cpresser/karatelight/KarateLight_v06b/switcher.jpg

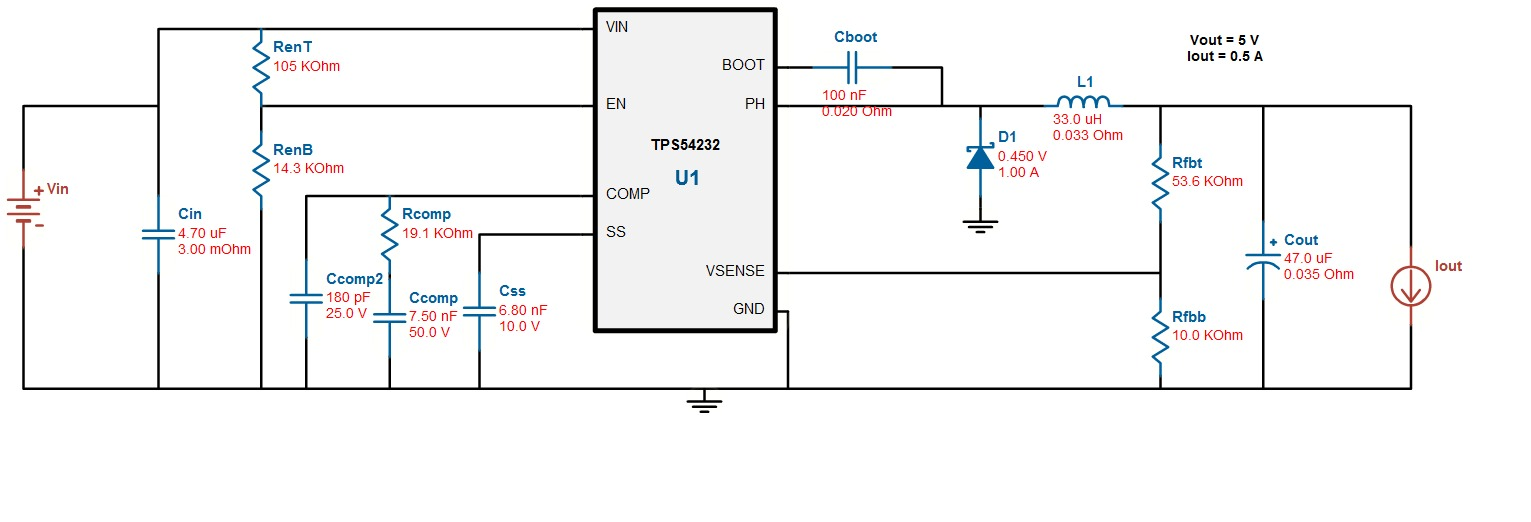
KarateLight_v06b/switcher.jpg
