cpresser/karatelight/KarateLight_v06b/bom/BOM.ods

Sheet: KarateLight BOM
Qty | THT | Reel | Value | Device | Package | Parts | Description | Lager | Reichelt | Preis10 | Digikey | Price 10
8 | Yes |  | PINHEAD_4W | PINHEAD_4W | MA04-1 | CON1, CON2, CON3, CON4, CON5, CON6, CON7, CON8 |  |  | PSS 254/4W | 4,03 €
3 | Yes |  |  | PINHD-2X4 | 2X04 | PIGGY_PWR, PIGGY_SIG, PIGGY_SUPPORT | PIN HEADER |  | MPE 094-2-008 | 6,55 € | S7072-ND | 19,65 €
2 |  | Yes | 100n | C-EUC0603 | C0603 | C3, C5 | CAPACITOR, European symbol | R
2 |  | Yes | 10k | R-EU_R0603 | R0603 | R25, R28 | RESISTOR, European symbol | R
6 |  | Yes | CTS742C083R | CTS742C083R | CTS742C083 | RN1, RN2, Rn3, RN4, RN5, RN6 | Chip Resistor Array 4 Single Resistor | R | BCN16 10K | 1,01 €
2 |  |  | 100u 24V | CPOL-EU153CLV-0605 | 153CLV-0605 | C1, C2 | POLARIZED CAPACITOR, European symbol |  | VF 100/35 K-D8 | 3,03 €
12 |  |  | IRF7103 | IRF7103 | SO08-IRF | T1, T2, T3, T4, T5, T6, T7, T8, T9, T10, T11, T12 | Dual HexFET Power Mosfet |  | IRF 7103 | 32,26 € | IRF7103PBF-ND | 43,18 €
1 |  |  | IRF7389 | IRF7389 | SO08-IRF | T13 | Complimentary Half Bridge HEXFET Power MOSFET |  | IRF 7389 | 4,79 € | IRF7389PBFCT-ND | 8,21 €
1 |  |  | TLC5947 | TLC5947 | TSSOP32 | IC1 | 24CH PWM LED Driver |  |  |  | 296-23576-5-ND | 49,88 €
1 | Yes |  | PG203J | PG203J | PG203J | PLUG_LDR | MIC/HEADPHONE JACK |  | EBS 35 | 2,67 €
1 | Yes |  |  | DCJ0303 | DCJ0303 | VIN | DC POWER JACK |  | HEBW 21 | 2,10 €
8 | Yes |  | PINHEAD_4W | PINHEAD_4W | MA04-1 | CON1, CON2, CON3, CON4, CON5, CON6, CON7, CON8 |  |  | PSS 254/4W | 4,03 €
3 | Yes |  |  | PINHD-2X4 | 2X04 | PIGGY_PWR, PIGGY_SIG, PIGGY_SUPPORT | PIN HEADER |  | MPE 087-2-008 | 5,04 € | PH2-230/120-081-ND | 4,59 €
6 |  | Yes | 10k | R-EU_R0603 | R0603 | R25, R26, R28, R31, R32, R33 | RESISTOR, European symbol | R
2 |  | Yes | 10n | C-EUC0603 | C0603 | C7, C11 | CAPACITOR, European symbol
2 |  | Yes | 15p | C-EUC0603 | C0603 | C15, C16 | CAPACITOR, European symbol
1 |  | Yes | 180p | C-EUC0603 | C0603 | C9 | CAPACITOR, European symbol
1 |  | Yes | 19.1k | R-EU_R0603 | R0603 | R27 | RESISTOR, European symbol | 150 20k5
6 |  | Yes | 100n | C-EUC0603 | C0603 | C6, C10, C12, C5, C13, C14 | CAPACITOR, European symbol | R
1 |  |  | 1u | C-EUC0805 | C0805 | C18 | CAPACITOR, European symbol |  | X7R-G0805 1,0/16 | 0,40 €
1 |  | Yes | 43k | R-EU_R0603 | R0603 | R30 | RESISTOR, European symbol
1 |  | Yes | 7n5 | C-EUC0603 | C0603 | C8 | CAPACITOR, European symbol
1 |  | Yes | 8k2 | R-EU_R0603 | R0603 | R29 | RESISTOR, European symbol
6 |  | Yes | CTS742C083R | CTS742C083R | CTS742C083 | RN1, RN2, Rn3, RN4, RN5, RN6 | Chip Resistor Array 4 Single Resistor |  | BCN16 10K | 1,01 €
1 |  | DR | green | LEDCHIP-LED0805 | CHIP-LED0805 | LED2 | LED |  | SMD-LED 0805 GN | 0,67 €
1 |  | DR | red | LEDCHIP-LED0805 | CHIP-LED0805 | LED1 | LED |  | SMD-LED 0805 RT | 0,67 €
1 |  |  | 20MHz | CRYSTALHC49UP | HC49UP | Q1 | CRYSTAL |  | 20,0000-HC49-SMD | 1,60 €
1 |  |  | 33u | L-EUPIS2816 | PIS2816 | L1 | INDUCTOR, European symbol |  | L-PIS2816 33µ | 5,21 €
2 |  |  | 4.7u | CPOL-EU153CLV-0405 | 153CLV-0405 | C3, C4 | POLARIZED CAPACITOR, European symbol |  | SMD ELKO 4,7/35 | 0,67 €
1 |  |  | USB-B-S | USB-B-S | USB-B-SMT | PLUG_USB | USB Connectors |  | USB BW SMD | 3,36 €
1 |  |  |  | R-EU_R4527 | R4527 | FUSE | RESISTOR, European symbol |  |  |  | F1228CT-ND | 19,28 €
2 |  |  | 100u 24V | CPOL-EU153CLV-0605 | 153CLV-0605 | C1, C2 | POLARIZED CAPACITOR, European symbol |  | VF 100/35 K-D8 | 3,03 €
1 |  |  |  | TASTER-9314_SMD | TASTER-9314_SMD | BOOT |  |  | Taster 9315 | 1,68 €
1 |  |  |  | SCHOTTKY-DIODESMD | SMB | D1 | Schottky Diode |  | MBRS 240 SMD | 1,85 €
12 |  |  | IRF7103 | IRF7103 | SO08-IRF | T1, T2, T3, T4, T5, T6, T7, T8, T9, T10, T11, T12 | Dual HexFET Power Mosfet |  | IRF 7103 | 32,26 €
1 |  |  | IRF7389 | IRF7389 | SO08-IRF | T13 | Complimentary Half Bridge HEXFET Power MOSFET |  | IRF 7389 | 4,79 €
1 |  |  | PIC18F4550_TQFP | PIC18F4550_TQFP | TQFP44 | IC2 | USB Microcontrollers with nanoWatt Technology High-Performance, Enhanced Flash, 28/40/44-Pin, |  | PIC 18F4550-I/PT | 48,73 €
1 |  |  | TLC5947 | TLC5947 | TSSOP32 | IC1 | 24CH PWM LED Driver |  |  |  | 296-23576-5-ND | 49,88 €
1 |  |  | TPS54232 | TPS54232 | SO-08 | IC3 | TPS54232 2-A, 28-V, 1-MHz, Step-Down DC-DC Converter With Eco-Mode |  |  |  | 296-24037-5-ND | 17,40 €
 |  |  |  |  |  |  |  |  |  | 171,44 € |  | 117,16 € | 28,86 €

Sheet: Staffelpreise
 |  |  | 10 | 25 | 100
TPS54232 | @Digikey | 296-24037-5-ND | 1,74 € | 1,41 € | 1,27 €
 | @Mouser | 595-TPS54232DR | 1,43 € | 1,29 € | 1,12 €
PIC18F4550 | @Digikey | PIC18F4550T-I/PTCT-ND | 5,04 € | 4,09 € | 4,00 €
 | @Reichelt | PIC 18F4550-I/PT | 4,87 € | 4,87 € | 4,87 €
 | @Mouser | 579-PIC18F4550-I/PT | 4,76 € | 3,87 € | 3,82 €
PIC18F45K50 | @Digikey | PIC18F45K50-I/PT-ND | 3,12 € | 2,38 € | 2,15 €
 | @Mouser | 579-PIC18F45K50-I/PT | 2,98 € | 2,27 € | 2,05 €
TLC5947DAP | @Mouser | 595-TLC5947DAP | 4,76 € | 4,28 € | 3,90 €
 | @Digikey | 296-23576-5-ND | 4,98 € | 4,98 € | 4,09 €
IRF7103 | Bei Digikey ab 4000 Günstiger

Sheet: Reel
Name | Digikey | Menge | Preis
Resistor Network 10k 1206 | YC164J-10KTR-ND | 5000 | 20,26
Cap 15p | 1276-1296-1-ND | 500 | 4,02
Cap 180p | 1276-1255-1-ND | 500 | 4,24
Cap 10n | 1276-1921-2-ND | 4000 | 13,34
Res 8k2 | RHM8.2KCFTR-ND | 5000 | 6,48
Cap 6,8n | 1276-2103-1-ND | 100 | 1,56
Res 43k | RHM43KCFTR-ND | 5000 | 6,48
Res 1k | 311-1.0KGRTR-ND | 5000 | 5,65

Sheet: Sicherungen
 |  | Price 10
5A, SMD, kein Halter | MFU06035.00CT-ND | 2,05
Schurter Inc. 0031.7701.11 | 486-1991-ND | 11,1 | Holder
 | OMT 125 5,0A | 5 | Fuse
Littelfuse Inc. 0154005.DR | F1228CT-ND | 19.28 | Fuse + Holder
