cpresser/karatelight/KarateLight_v06b/stencil/KarateLight-exp.dxf

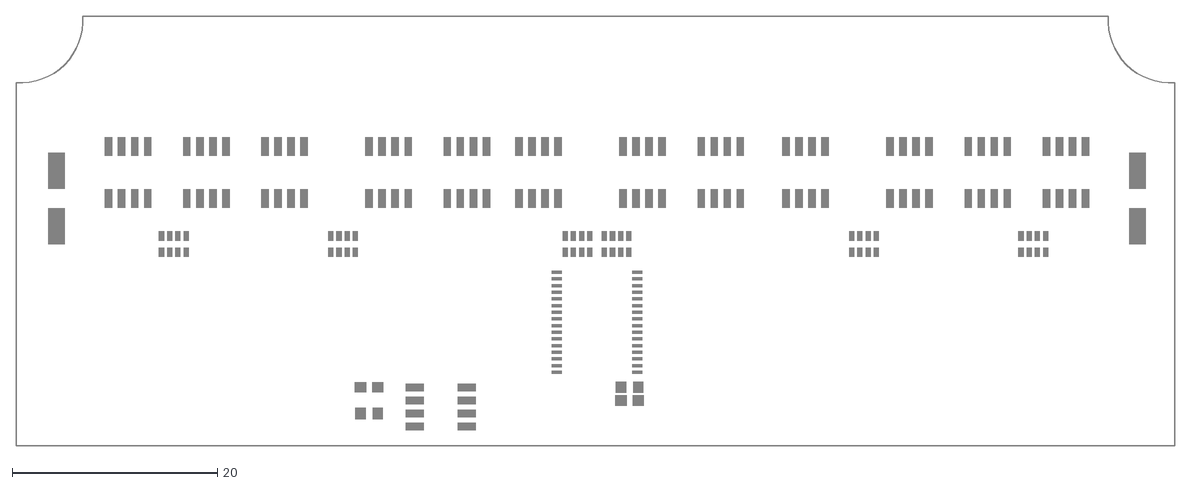
[picture p2: CAD file, 2017-12-09]
KarateLight_v06b/stencil/KarateLight-exp.dxf
113.0 x 41.9
