cpresser/karatelight/KarateLight_v06b/stencil/KarateLight.dxf

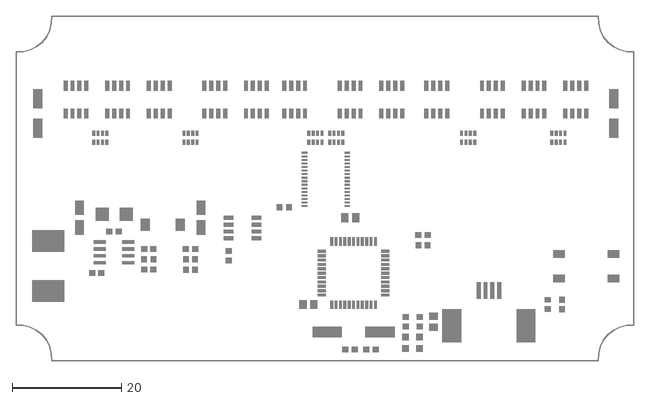
[picture p3: CAD file, 2017-12-09]
KarateLight_v06b/stencil/KarateLight.dxf
113.0 x 63.0
