cpresser/karatelight/(list of files, cad)

Other CAD files:
Firmware/karate_xc8.X/dist/18F4550/production/karate_xc8.X.production.obj
Firmware/karate_xc8.X/dist/18F45k50-relocation/production/karate_xc8.X.production.obj
Firmware/karate_xc8.X/dist/18F45k50/production/karate_xc8.X.production.obj
Firmware/karate_xc8.X/dist/default/production/karate_xc8.X.production.obj
