cpresser/karatelight/KarateLight_v06b/KarateLight.brd

## EAGLE design KarateLight_v06b/KarateLight.brd (2017-12-09)

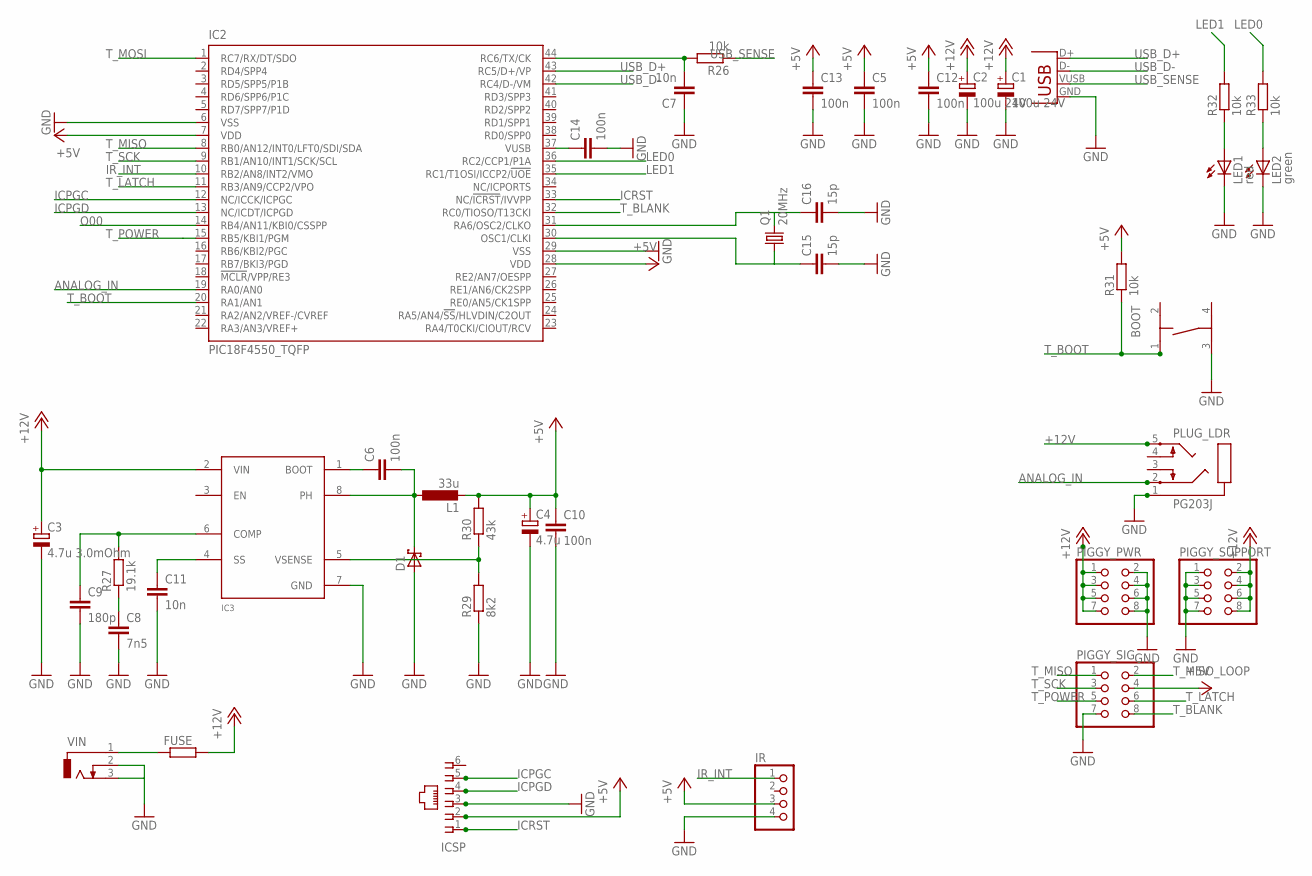
[picture p4: schematic KarateLight.sch, sheet 1]

Parts:
BOOT: TASTER-9314_SMD
C1, C2: 100u 24V; 153CLV-0605
C3: 4.7u 3.0mOhm; 153CLV-0405
C4: 4.7u; 153CLV-0405
C5, C13, C14: 100n; C0805K
C6, C10, C12: 100n; C0603
C7, C11: 10n; C0603
C8: 7n5; C0603
C9: 180p; C0603
C15, C16: 15p; C0603
D1: SCHOTTKY-DIODESMD; SMB
FUSE: R-EU_R4527; R4527
IC2: PIC18F4550_TQFP; TQFP44
IC3: TPS54232; SO-08
ICSP: 520250-3
IR: PINHD-1X4; 1X04
L1: 33u; PIS2816
LED1: red; CHIP-LED0805
LED2: green; CHIP-LED0805
PIGGY_PWR: PINHD-2X4; 2X04
PIGGY_SIG: PINHD-2X4; 2X04
PIGGY_SUPPORT: PINHD-2X4; 2X04
PLUG_LDR: PG203J
PLUG_USB: USB-B-S; USB-B-SMT
Q1: 20MHz; HC49UP
R26, R31, R32, R33: 10k; R0603
R27: 19.1k; R0603
R29: 8k2; R0603
R30: 43k; R0603
VIN: DCJ0303

Connections:
+5V: C4.+, C5.1, C10.1, C12.1, C13.1, IC2.7 (VDD), IC2.28 (VDD), ICSP.2, IR.3, L1.2, PIGGY_SIG.4, R30.2, R31.2; also elsewhere on the board
+12V: C1.+, C2.+, C3.+, FUSE.2, IC3.2 (VIN), PIGGY_PWR.1, PIGGY_PWR.3, PIGGY_PWR.5, PIGGY_PWR.7, PIGGY_SUPPORT.2, PIGGY_SUPPORT.4, PIGGY_SUPPORT.6, PIGGY_SUPPORT.8, PLUG_LDR.5; also elsewhere on the board
ANALOG_IN: IC2.19 (RA0/AN0), PLUG_LDR.2
BOOST: C6.2, D1.C, IC3.8 (PH), L1.1
GND: BOOT.3, C1.-, C2.-, C3.-, C4.-, C5.2, C7.1, C8.2, C9.2, C10.2, C11.2, C12.2, C13.2, C14.2, C15.2, C16.2, D1.A, IC2.6 (VSS), IC2.29 (VSS), IC3.7 (GND), ICSP.3, IR.4, LED1.C, LED2.C, PIGGY_PWR.2, PIGGY_PWR.4, PIGGY_PWR.6, PIGGY_PWR.8, PIGGY_SIG.7, PIGGY_SUPPORT.1, PIGGY_SUPPORT.3, PIGGY_SUPPORT.5, PIGGY_SUPPORT.7, PLUG_LDR.1, PLUG_USB.GND, R29.1, VIN.2, VIN.3; also elsewhere on the board
ICPGC: IC2.12 (NC/ICCK/ICPGC), ICSP.5
ICPGD: IC2.13 (NC/ICDT/ICPGD), ICSP.4
ICRST: IC2.33 (NC/!ICRST!/IVVPP), ICSP.1
IR_INT: IC2.10 (RB2/AN8/INT2/VMO), IR.1
LED0: IC2.36 (RC2/CCP1/P1A), R33.2
LED1: IC2.35 (RC1/T1OSI/ICCP2/!UOE), R32.2
unnamed: C14.1, IC2.37 (VUSB)
unnamed: C15.1, IC2.30 (OSC1/CLKI), Q1.1
unnamed: C16.1, IC2.31 (RA6/OSC2/CLKO), Q1.2
unnamed: C8.1, R27.1
unnamed: C7.2, IC2.44 (RC6/TX/CK), R26.2
unnamed: LED1.A, R32.1
unnamed: C9.1, IC3.6 (COMP), R27.2
unnamed: LED2.A, R33.1
unnamed: C11.1, IC3.4 (SS)
unnamed: IC3.5 (VSENSE), R29.2, R30.1
unnamed: C6.1, IC3.1 (BOOT)
O00: IC2.14 (RB4/AN11/KBI0/CSSPP); also elsewhere on the board
T_BLANK: IC2.32 (RC0/TIOSO/T13CKI), PIGGY_SIG.8; also elsewhere on the board
T_BOOT: BOOT.1, IC2.20 (RA1/AN1), R31.1
T_LATCH: IC2.11 (RB3/AN9/CCP2/VPO), PIGGY_SIG.6; also elsewhere on the board
T_MISO: IC2.8 (RB0/AN12/INT0/LFT0/SDI/SDA), PIGGY_SIG.1
T_MISO_LOOP: PIGGY_SIG.2; also elsewhere on the board
T_MOSI: IC2.1 (RC7/RX/DT/SDO); also elsewhere on the board
T_POWER: IC2.15 (RB5/KBI1/PGM), PIGGY_SIG.5; also elsewhere on the board
T_SCK: IC2.9 (RB1/AN10/INT1/SCK/SCL), PIGGY_SIG.3; also elsewhere on the board
USB_D+: IC2.43 (RC5/D+/VP), PLUG_USB.D+
USB_D-: IC2.42 (RC4/D-/VM), PLUG_USB.D-
USB_SENSE: PLUG_USB.VUSB (VBUS), R26.1
VIN: FUSE.1, VIN.1

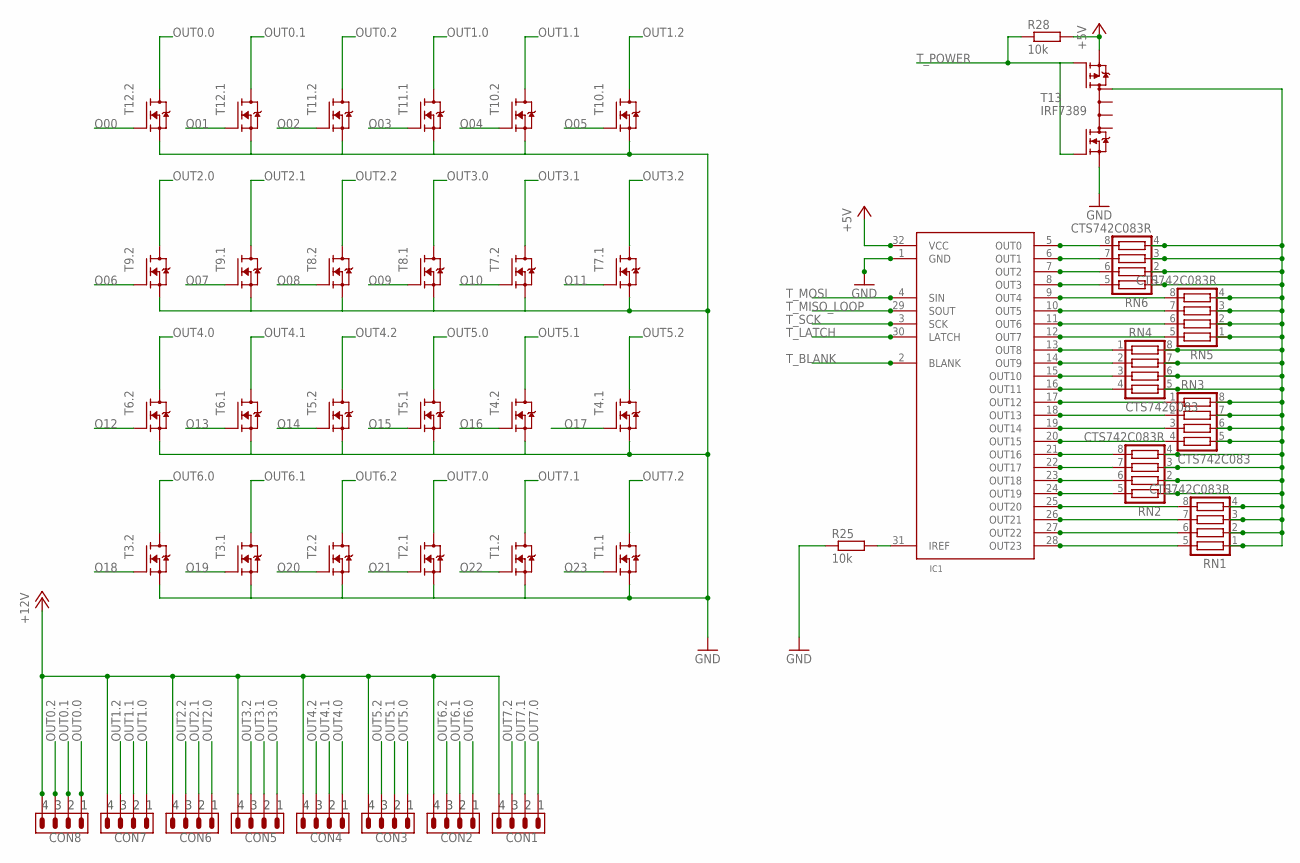
[picture p5: schematic KarateLight.sch, sheet 2]

Parts:
CON1, CON2, CON3, CON4, CON5, CON6, CON7, CON8: PINHEAD_4W; MA04-1
IC1: TLC5947; TSSOP32
R25, R28: 10k; R0603
RN1, RN2, RN5, RN6: CTS742C083R; CTS742C083
RN3, RN4: CTS742C083
T1, T2, T3, T4, T5, T6, T7, T8, T9, T10, T11, T12: IRF7103; SO08-IRF
T13: IRF7389; SO08-IRF

Connections:
+5V: IC1.32 (VCC), R28.2, T13.3 (P-S); also elsewhere on the board
+12V: CON1.4, CON2.4, CON3.4, CON4.4, CON5.4, CON6.4, CON7.4, CON8.4; also elsewhere on the board
FET-ONOFF: RN1.1, RN1.2, RN1.3, RN1.4, RN2.1, RN2.2, RN2.3, RN2.4, RN3.5, RN3.6, RN3.7, RN3.8, RN4.5, RN4.6, RN4.7, RN4.8, RN5.1, RN5.2, RN5.3, RN5.4, RN6.1, RN6.2, RN6.3, RN6.4, T13.5 (D)
GND: IC1.1 (GND), R25.1, T1.1 (S), T1.3 (S), T2.1 (S), T2.3 (S), T3.1 (S), T3.3 (S), T4.1 (S), T4.3 (S), T5.1 (S), T5.3 (S), T6.1 (S), T6.3 (S), T7.1 (S), T7.3 (S), T8.1 (S), T8.3 (S), T9.1 (S), T9.3 (S), T10.1 (S), T10.3 (S), T11.1 (S), T11.3 (S), T12.1 (S), T12.3 (S), T13.1 (N-S); also elsewhere on the board
unnamed: IC1.31 (IREF), R25.2
O00: IC1.5 (OUT0), RN6.8 (5), T12.4 (G); also elsewhere on the board
O01: IC1.6 (OUT1), RN6.7 (6), T12.2 (G)
O02: IC1.7 (OUT2), RN6.6 (7), T11.4 (G)
O03: IC1.8 (OUT3), RN6.5 (8), T11.2 (G)
O04: IC1.9 (OUT4), RN5.8 (5), T10.4 (G)
O05: IC1.10 (OUT5), RN5.7 (6), T10.2 (G)
O06: IC1.11 (OUT6), RN5.6 (7), T9.4 (G)
O07: IC1.12 (OUT7), RN5.5 (8), T9.2 (G)
O08: IC1.13 (OUT8), RN4.1, T8.4 (G)
O09: IC1.14 (OUT9), RN4.2, T8.2 (G)
O10: IC1.15 (OUT10), RN4.3, T7.4 (G)
O11: IC1.16 (OUT11), RN4.4, T7.2 (G)
O12: IC1.17 (OUT12), RN3.1, T6.4 (G)
O13: IC1.18 (OUT13), RN3.2, T6.2 (G)
O14: IC1.19 (OUT14), RN3.3, T5.4 (G)
O15: IC1.20 (OUT15), RN3.4, T5.2 (G)
O16: IC1.21 (OUT16), RN2.8 (5), T4.4 (G)
O17: IC1.22 (OUT17), RN2.7 (6), T4.2 (G)
O18: IC1.23 (OUT18), RN2.6 (7), T3.4 (G)
O19: IC1.24 (OUT19), RN2.5 (8), T3.2 (G)
O20: IC1.25 (OUT20), RN1.8 (5), T2.4 (G)
O21: IC1.26 (OUT21), RN1.7 (6), T2.2 (G)
O22: IC1.27 (OUT22), RN1.6 (7), T1.4 (G)
O23: IC1.28 (OUT23), RN1.5 (8), T1.2 (G)
OUT0.0: CON8.1, T12.6 (D)
OUT0.1: CON8.2, T12.8 (D)
OUT0.2: CON8.3, T11.6 (D)
OUT1.0: CON7.1, T11.8 (D)
OUT1.1: CON7.2, T10.6 (D)
OUT1.2: CON7.3, T10.8 (D)
OUT2.0: CON6.1, T9.6 (D)
OUT2.1: CON6.2, T9.8 (D)
OUT2.2: CON6.3, T8.6 (D)
OUT3.0: CON5.1, T8.8 (D)
OUT3.1: CON5.2, T7.6 (D)
OUT3.2: CON5.3, T7.8 (D)
OUT4.0: CON4.1, T6.6 (D)
OUT4.1: CON4.2, T6.8 (D)
OUT4.2: CON4.3, T5.6 (D)
OUT5.0: CON3.1, T5.8 (D)
OUT5.1: CON3.2, T4.6 (D)
OUT5.2: CON3.3, T4.8 (D)
OUT6.0: CON2.1, T3.6 (D)
OUT6.1: CON2.2, T3.8 (D)
OUT6.2: CON2.3, T2.6 (D)
OUT7.0: CON1.1, T2.8 (D)
OUT7.1: CON1.2, T1.6 (D)
OUT7.2: CON1.3, T1.8 (D)
T_BLANK: IC1.2 (BLANK); also elsewhere on the board
T_LATCH: IC1.30 (LATCH); also elsewhere on the board
T_MISO_LOOP: IC1.29 (SOUT); also elsewhere on the board
T_MOSI: IC1.4 (SIN); also elsewhere on the board
T_POWER: R28.1, T13.2 (N-G), T13.4 (P-G); also elsewhere on the board
T_SCK: IC1.3 (SCK); also elsewhere on the board

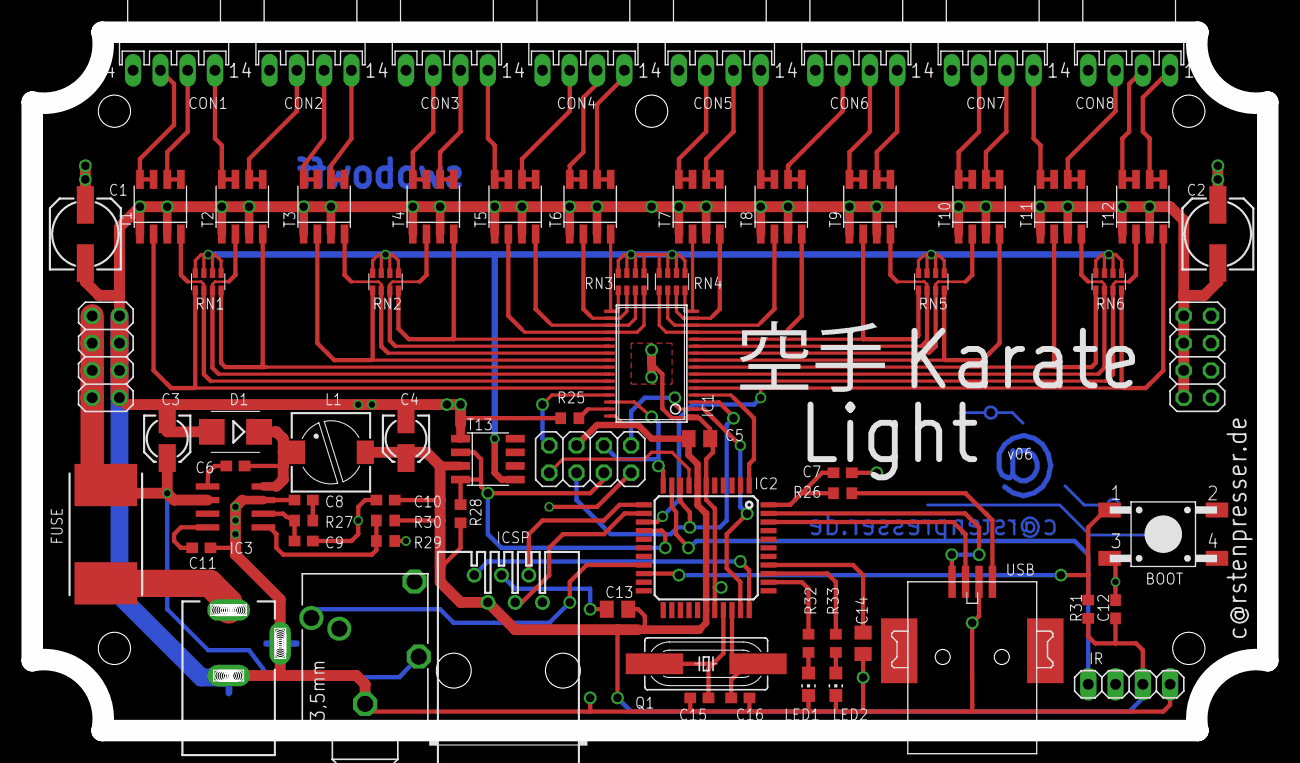
[picture p6: board KarateLight.brd from above]

Board: 2 copper layers, 115.0 x 65.0 mm, 70 parts (0 on the bottom side), 84 nets.
